sujayt123/lazy-radio-station/Slides.pdf

# Lazy Man’s Radio

Chris Chivetta, Joseph D’amico, Stefan Olesnyckyj,

# Sujay Tadwalkar, Anika Zaman

# The Concept

MSP430 implementation of a lazy man's radio that integrates a soundboard, shift register, LCD display, and pir sensor to allow a user to lazily flip through his or her favorite tracks with a wave of the hand.

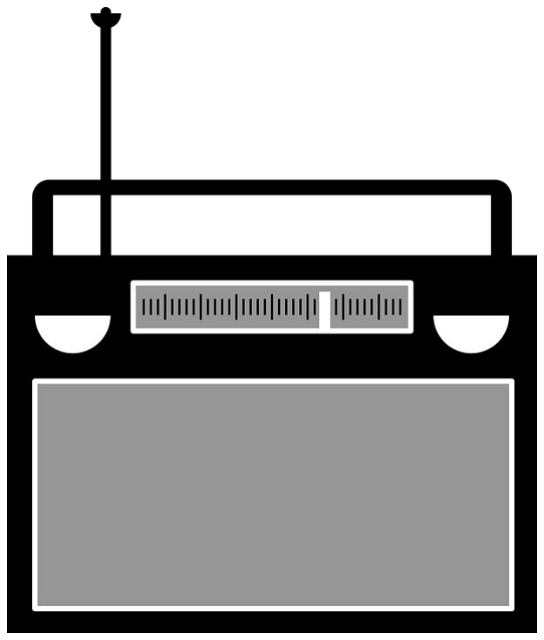
[picture p3: figure]

# History and Demand

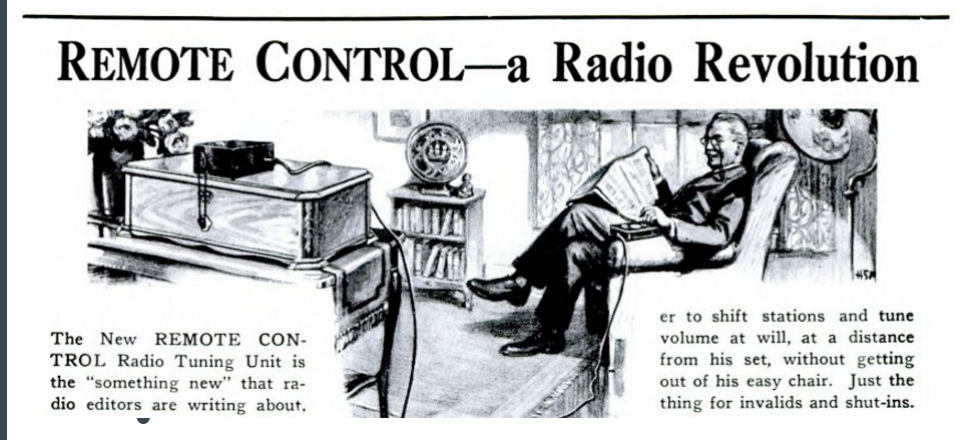
[picture p4: figure]

- Remote operation of music-playing devices has been desirable since the advent of radios
- Personal music devices such as mp3 players and cell phones with music apps
- Interfacing with personal music devices can be awkward and unwieldy in social settings, as you still have to touch the screen or buttons to change songs
- Being able to change song with a wave of your hand is extremely convenient

# Features of Lazy Man’s Radio

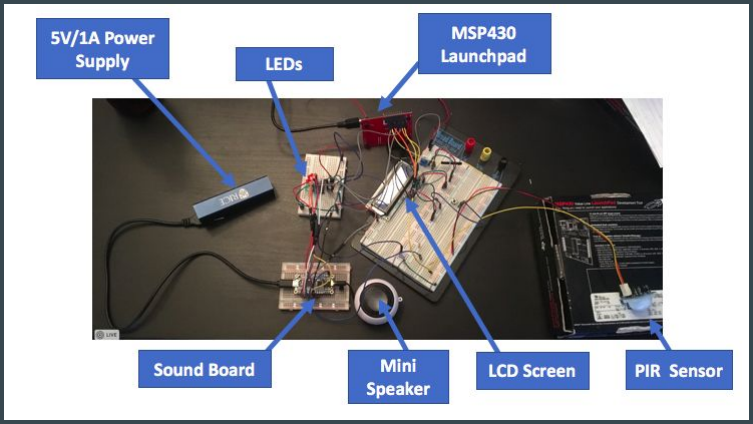
[picture p5: figure]

- LCD screen
- Motion Detector Track Selection
- Pushbutton Track Selection
- LED indicators
- Shift register
- Modify and reprogram the system to skip one, two or more tracks per motion
- Reorder the order in which to visit songs on the
soundboard
- A (customizable) soundboard pre-loaded with eight of today’s most popular hits

# Parts

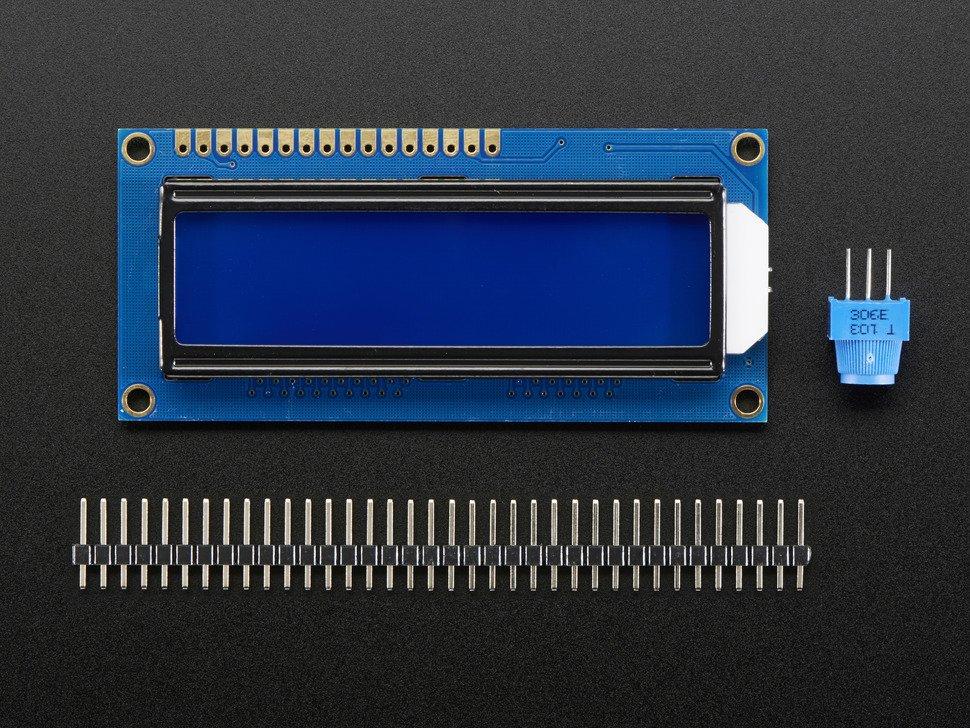
[picture p6: figure]

- 16x2 LCD Screen
- Display track name for user
- We are not using the SPI/I2C backpack for this model

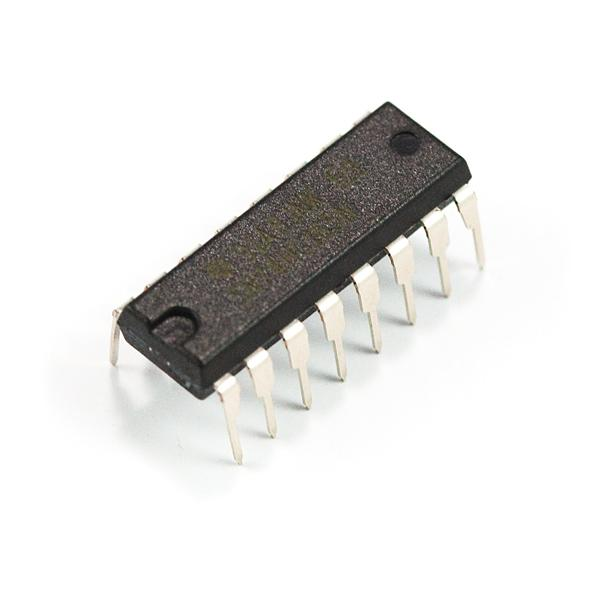
[picture p7: figure]

- 74HC595 8-bit Shift Register
- Reduce number of pins of the MSP430 that the Soundboard uses
- Serves as 1-cold decoder

# Parts

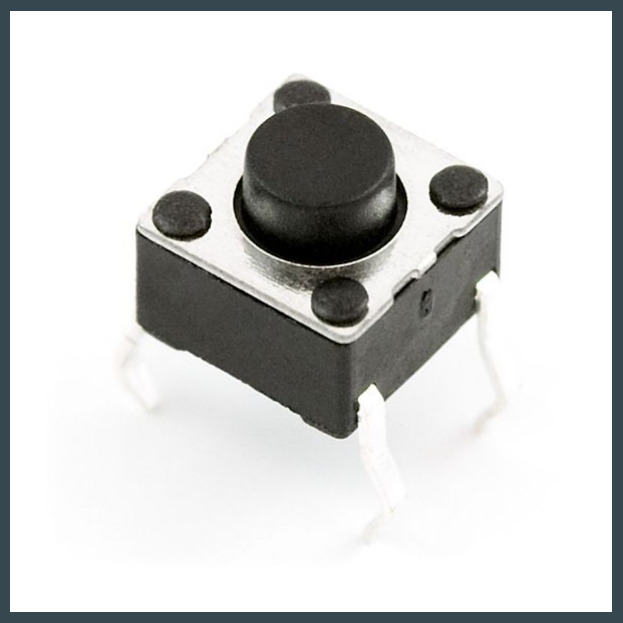
[picture p8: figure]

- Mini Pushbutton
- Move to the next song
- Audio FX Sound Board
- Audio sound effects and also has built in storage that holds up to 15 minutes of compressed audio

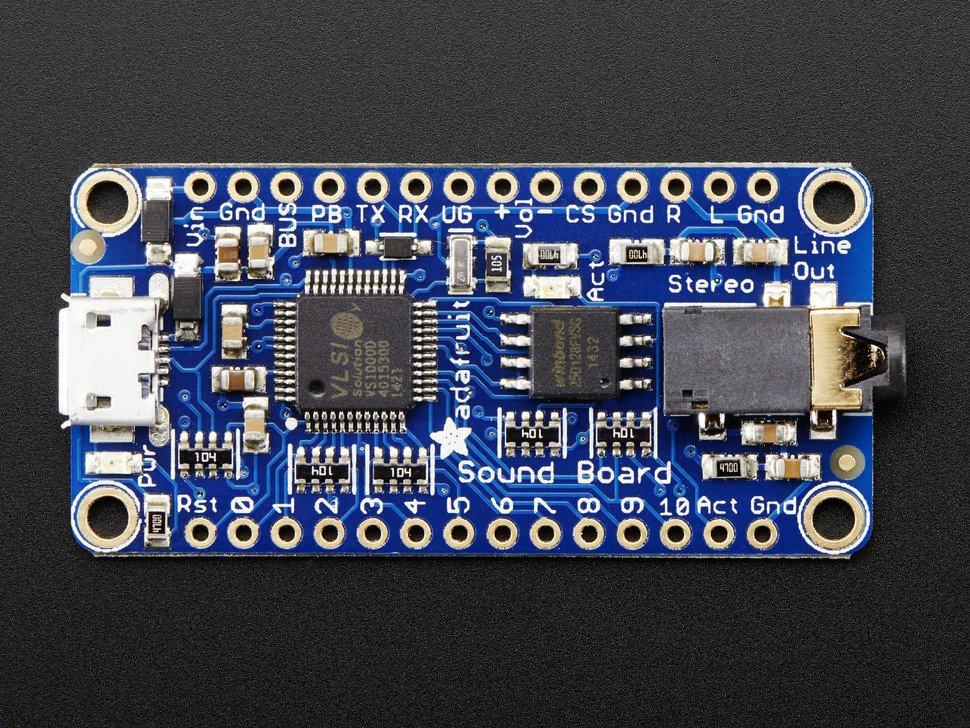
[picture p9: figure]

# Parts

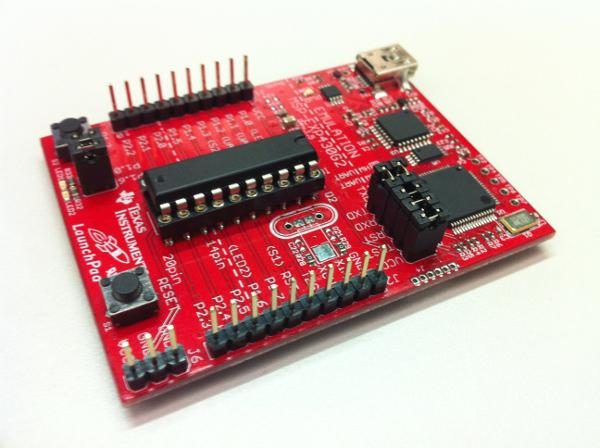
[picture p10: figure]

## - MSP430 Launchpad ○ Using the MSP430G2553

## model - Low cost ○ Low power consumption ○ Easy to interface with GPIO

## pins

# Parts

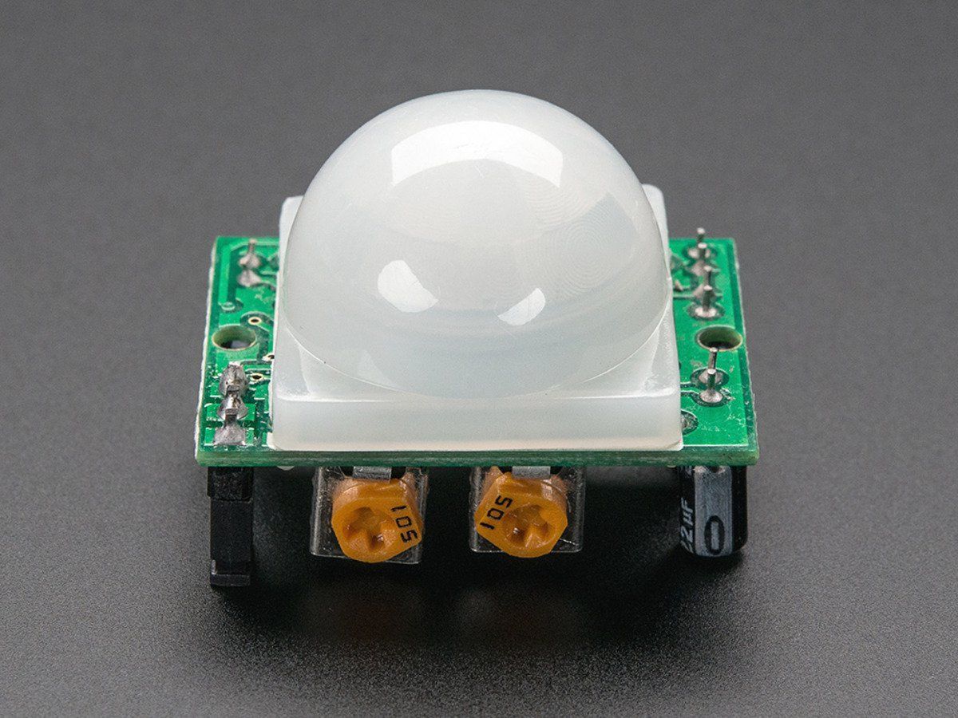
[picture p11: figure]

- PIR Motion Sensor
- Pyroelectric (passive) InfraRed Sensor
- Detect hand movements in order to move to the next song.
- Fairly low power consumption

# Parts

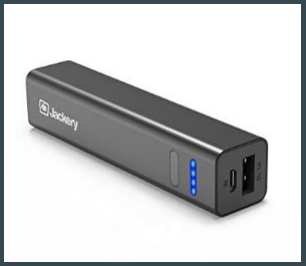
[picture p12: figure]

- 5V/1A USB Power Supply
- Power the speaker and soundboard

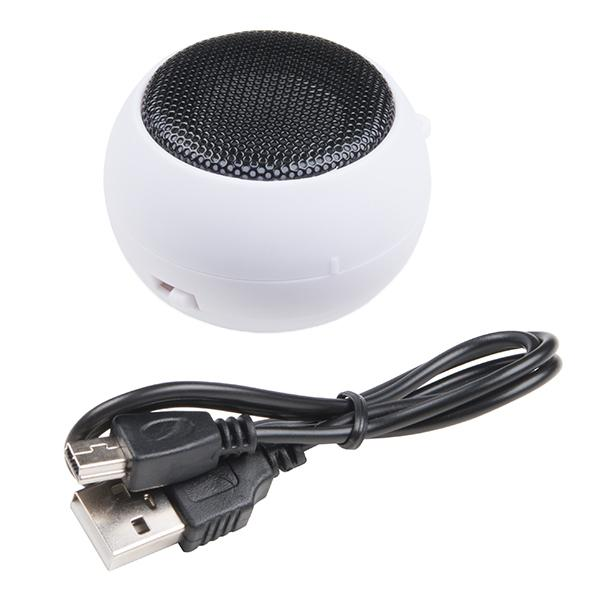
[picture p13: figure]

- Mini Speaker
- Play the sounds from the soundboard

# Schematic

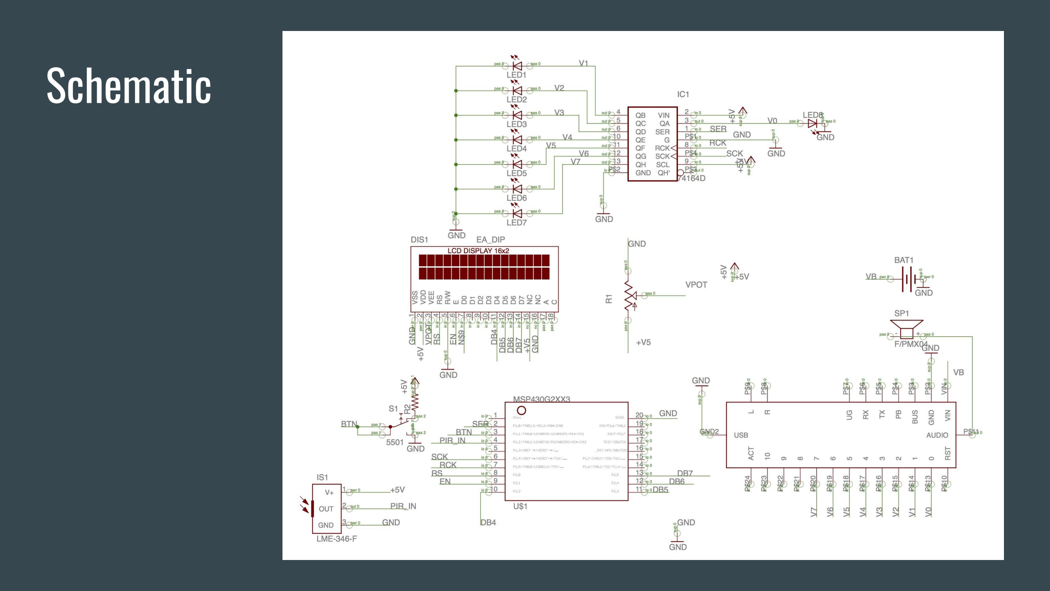
[picture p14: page 10]

# Hardware Architecture

## - Interface with soundboard ● Interface with the LCD ● Interface with a motion sensor

# Soundboard

- Adafruit AudioFX soundboard
- Low cost
- Simplicity
- Soundboard has 11 pins
- Just have to drive a corresponding pin low to play a corresponding song
- MSP430 has limited number of GPIO pins ■ Had to find solution

# The Solution

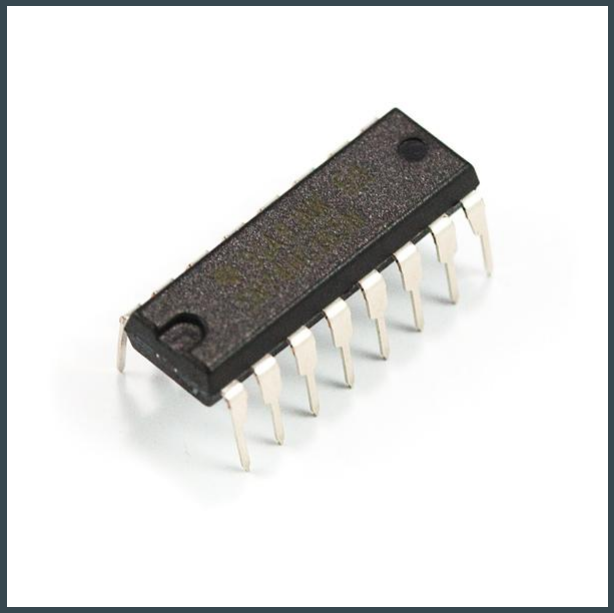
[picture p15: figure]

## - 1-Cold Decoder (Initially) - Control 16 pins with only 4 GPIO pins of the MSP430 - Fear of timing issues - Switched to sequential equivalent - 74HC595 shift register ■ Control 8 pins with only 3 GPIO pins ■ Could scale with more shift registers if necessary

# The LCD Display

- Initial considerations
- Wanted to use fewer GPIO pins
- Tried using SPI/I2C backpack
■ | Only needed 3 to 4 pins instead of 6
| or 7 pins
■ | Support for the MSP430 is limited
■ | Arduino drivers were written in C++
| ● Difficult to port
- Decided to use traditional interface with LCD display
- LCD Hardware
- RS Pin
- RW pin
- E pin
- DB4 to DB7
- DB0 to DB3
- Initialization commands
- Can configure LCD in different bit modes
- We used 4 bit mode
- Incorporated Kevin Lin’s LCD device driver

# Motion Sensor

- Flight-Sensor
- Get accurate readings of detected objects in the vicinity
- I2C comatability
■ I2C was very difficult to implement
- PIR Motion sensor
- Less accurate
- Only 1 bit of information
- Much easier to use with the rest of the system
- Requires only 1 GPIO bit
■ Needs to interface with the ADC
- Tuned sensitivity

# Software Architecture

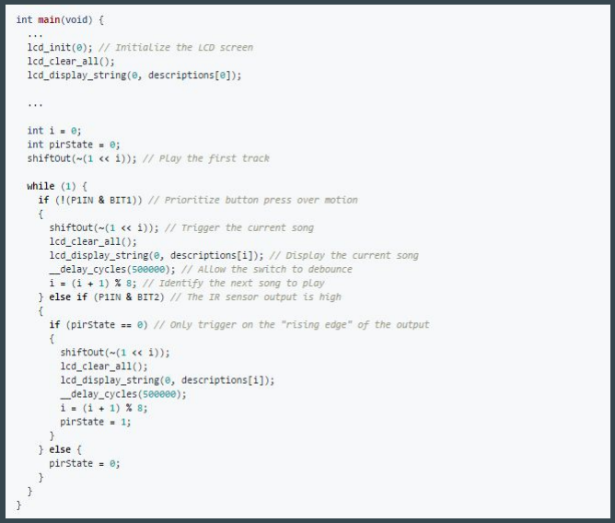
[picture p16: figure]

- Drivers
- Open Source
- Kevin Lin
- Used these to interface with shift register and MSP430 from a high level
- Polling system
- Poll switchbutton and PIR
- Planning on using interrupts i the future
- Not enough time to organize an interrupt system

# Class Concepts

- Soldering
- Breadboarding
- PCB design
- Sensor inputs
- ADC Utilization

# Next Steps

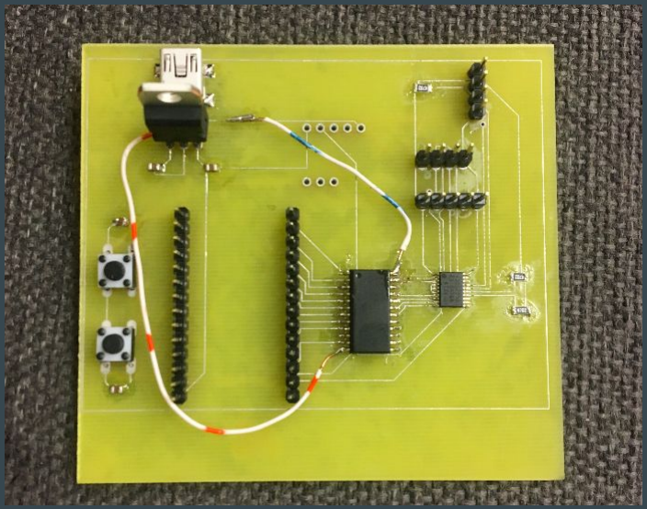
[picture p17: figure]

- Implementing our system design on our PCB
- Reorganizing software to use an interrupt-enabled system instead of a polling system
- Using a more sophisticated motion sensor
- Flight Sensor
- Using I2C/SPI to interface with the LCD screen
- Upgrading sound board
