sujayt123/lazy-radio-station/modifiedradio.pdf

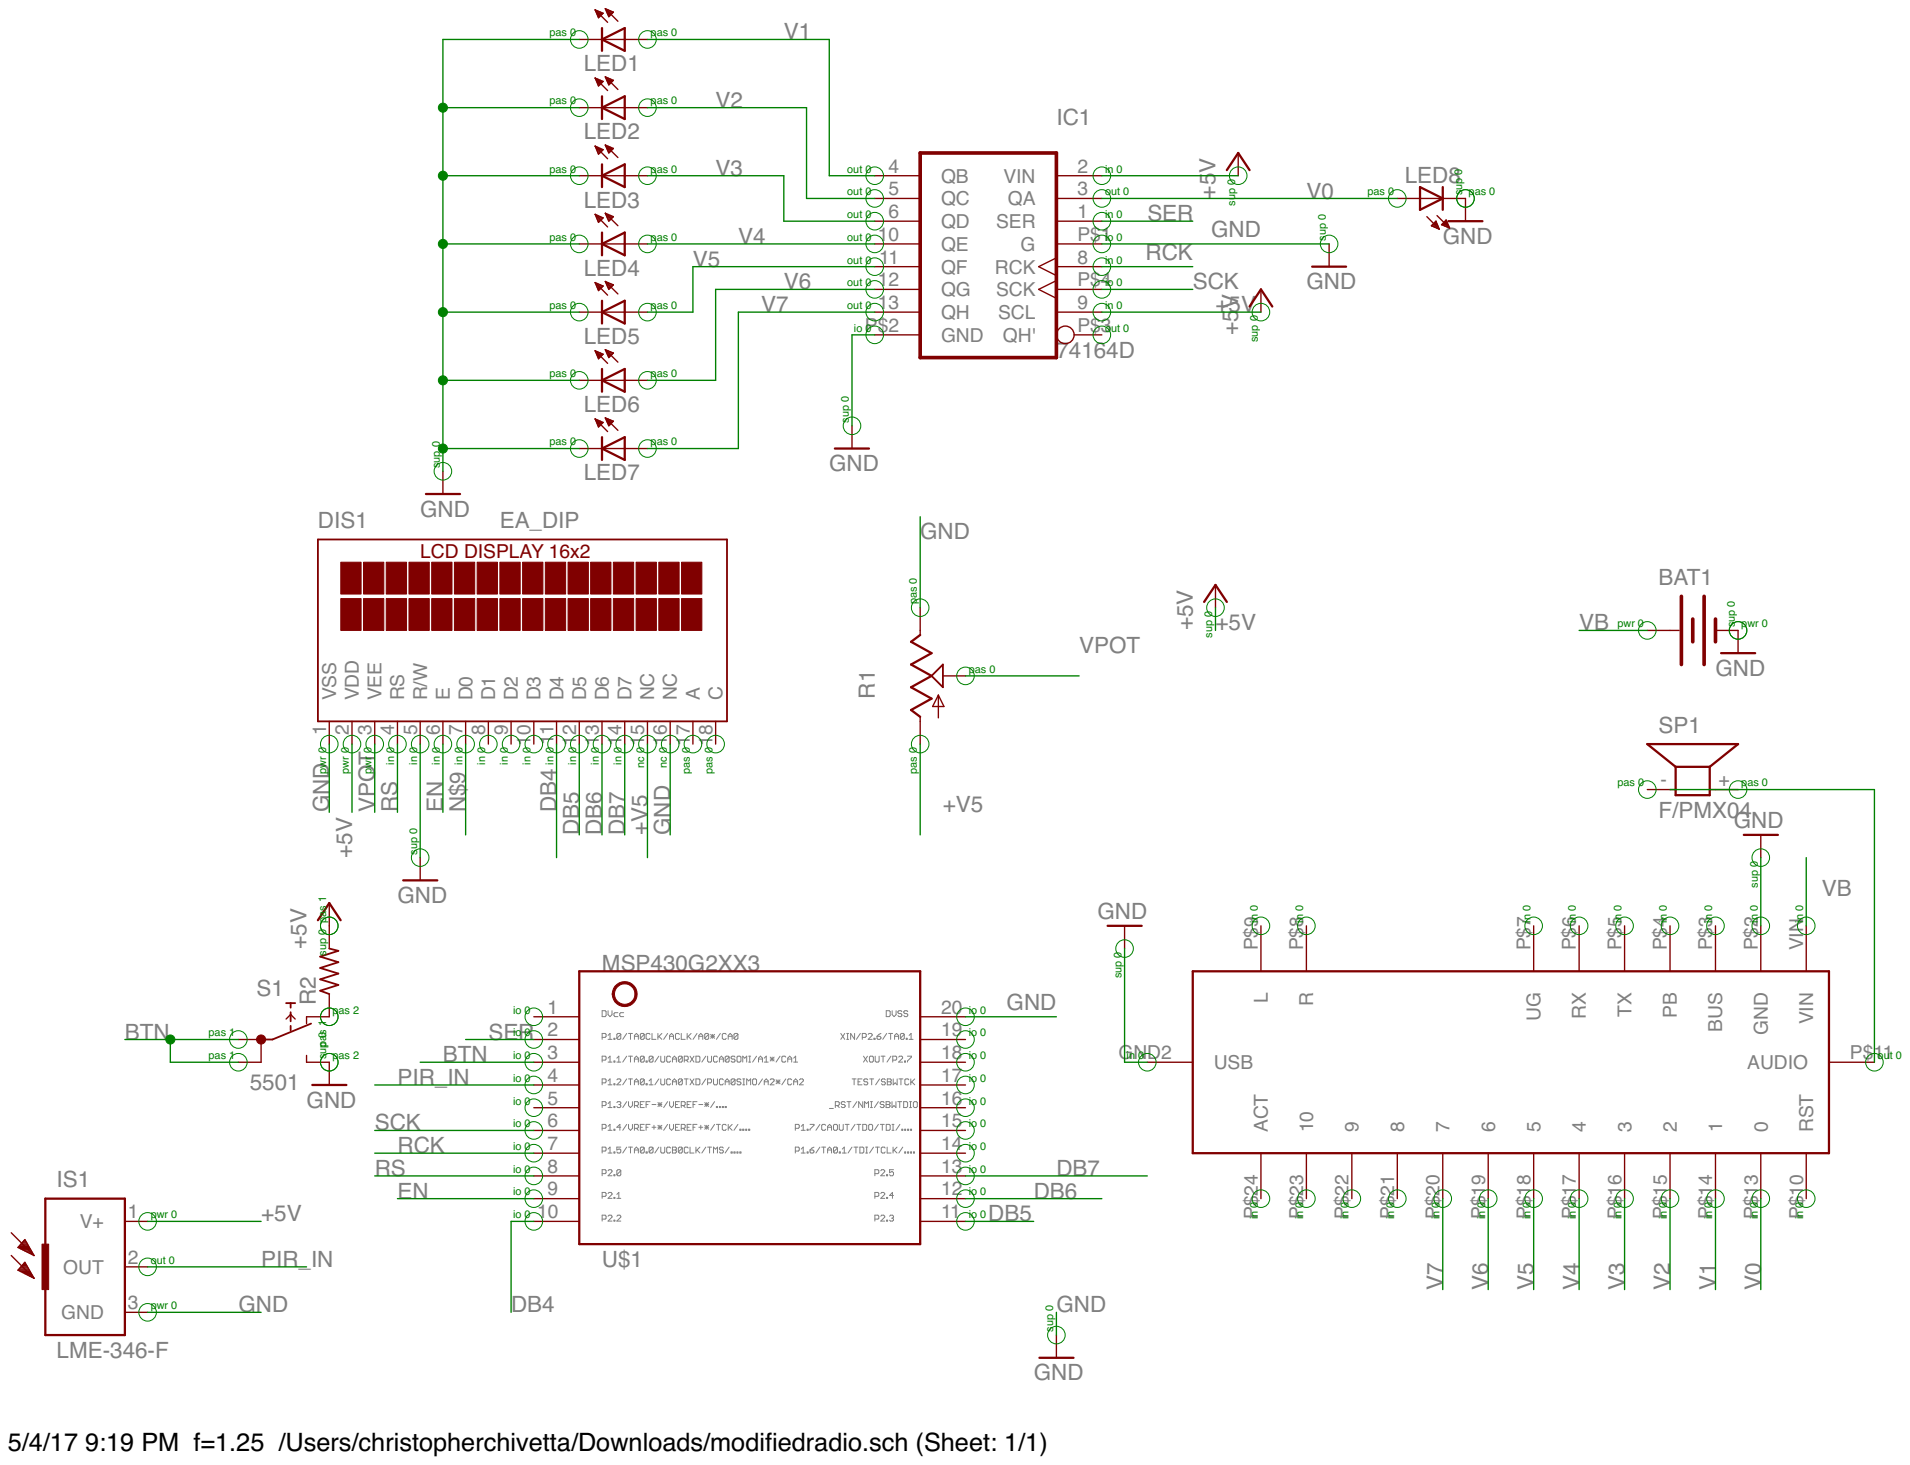
[picture p18: page 1]

pas 1 pas 1 sup 0 sup 0

5/4/17 9:19 PM f=1.25 /Users/christopherchivetta/Downloads/modifiedradio.sch (Sheet: 1/1)
