sujayt123/lazy-radio-station/modifiedradio.sch

## EAGLE design modifiedradio.sch (2017-05-05)

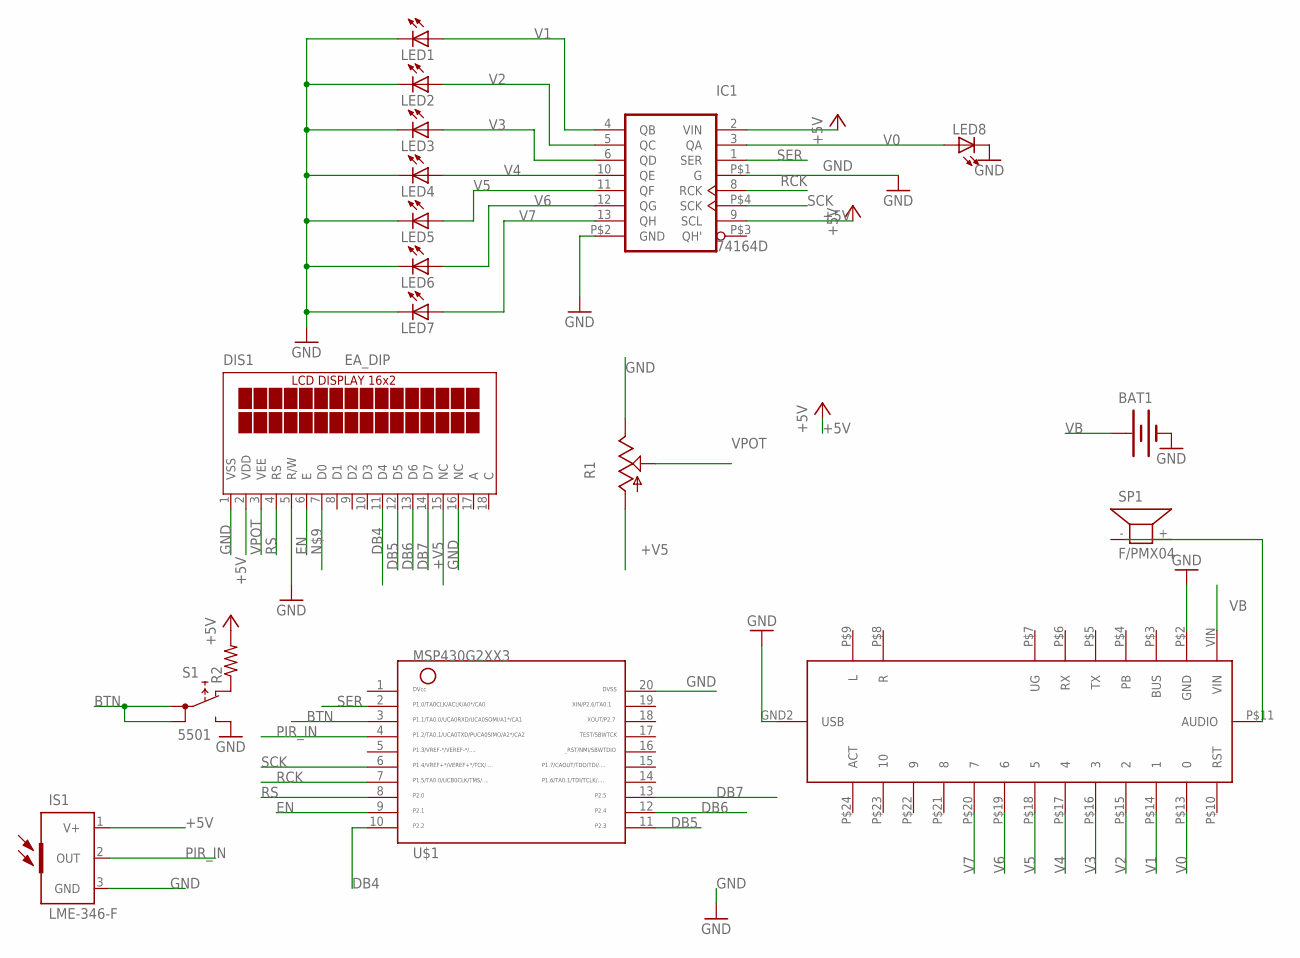
[picture p19: schematic modifiedradio.sch]

Parts:
BAT1: BATTERY; BATTERY_PACK_2AA
DIS1: EA_DIP
IC1: 74164D; SO14
IS1: LME-346-F; TO39
LED1, LED2, LED3, LED4, LED5, LED6, LED7, LED8: LED10MM
R1: TRIM_US-RS3; RS3
R2: R-US_0204/2V; 0204V
S1: 5501
SP1: F/PMX04; F/PMX04A
U$1: MSP430G2XX3TSSOP; PW20
U$2: SOUNDBOARD

Connections:
+5V: DIS1.2 (VDD), IC1.2 (VIN), IC1.9 (SCL), IS1.1 (V+), R2.2
+V5: DIS1.15 (NC), R1.A
BTN: S1.1A, S1.1B, U$1.3
DB4: DIS1.11 (D4), U$1.10
DB5: DIS1.12 (D5), U$1.11
DB6: DIS1.13 (D6), U$1.12
DB7: DIS1.14 (D7), U$1.13
EN: DIS1.6 (E), U$1.9
GND: BAT1.GND (-), DIS1.1 (VSS), DIS1.5 (R/W), DIS1.16 (NC), IC1.P$1 (G), IC1.P$2 (GND), IS1.3 (GND), LED1.K (C), LED2.K (C), LED3.K (C), LED4.K (C), LED5.K (C), LED6.K (C), LED7.K (C), LED8.K (C), R1.E, S1.NO, U$1.20, U$2.GND2 (USB), U$2.P$2 (GND)
unnamed: SP1.+ (2), U$2.P$11 (AUDIO)
unnamed: R2.1, S1.NC
PIR_IN: IS1.2 (OUT), U$1.4
RCK: IC1.8 (RCK), U$1.7
RS: DIS1.4 (RS), U$1.8
SCK: IC1.P$4 (SCK), U$1.6
SER: IC1.1 (SER), U$1.2
V0: IC1.3 (QA), LED8.A, U$2.P$13 (0)
V1: IC1.4 (QB), LED1.A, U$2.P$14 (1)
V2: IC1.5 (QC), LED2.A, U$2.P$15 (2)
V3: IC1.6 (QD), LED3.A, U$2.P$16 (3)
V4: IC1.10 (QE), LED4.A, U$2.P$17 (4)
V5: IC1.11 (QF), LED5.A, U$2.P$18 (5)
V6: IC1.12 (QG), LED6.A, U$2.P$19 (6)
V7: IC1.13 (QH), LED7.A, U$2.P$20 (7)
VB: BAT1.3V (+), U$2.VIN
VPOT: DIS1.3 (VEE), R1.S
