sujayt123/lazy-radio-station/(commit log)

2017-05-05 circuit img updated
2017-05-05 added schematic and labeled image
    [modifiedradio.sch]
2017-05-05 added schematic
    [modifiedradio.sch]
